USSTRocketry/hardware/README.md

USST Rocketry Avionics hardware

Telemetry board (Infozilla)
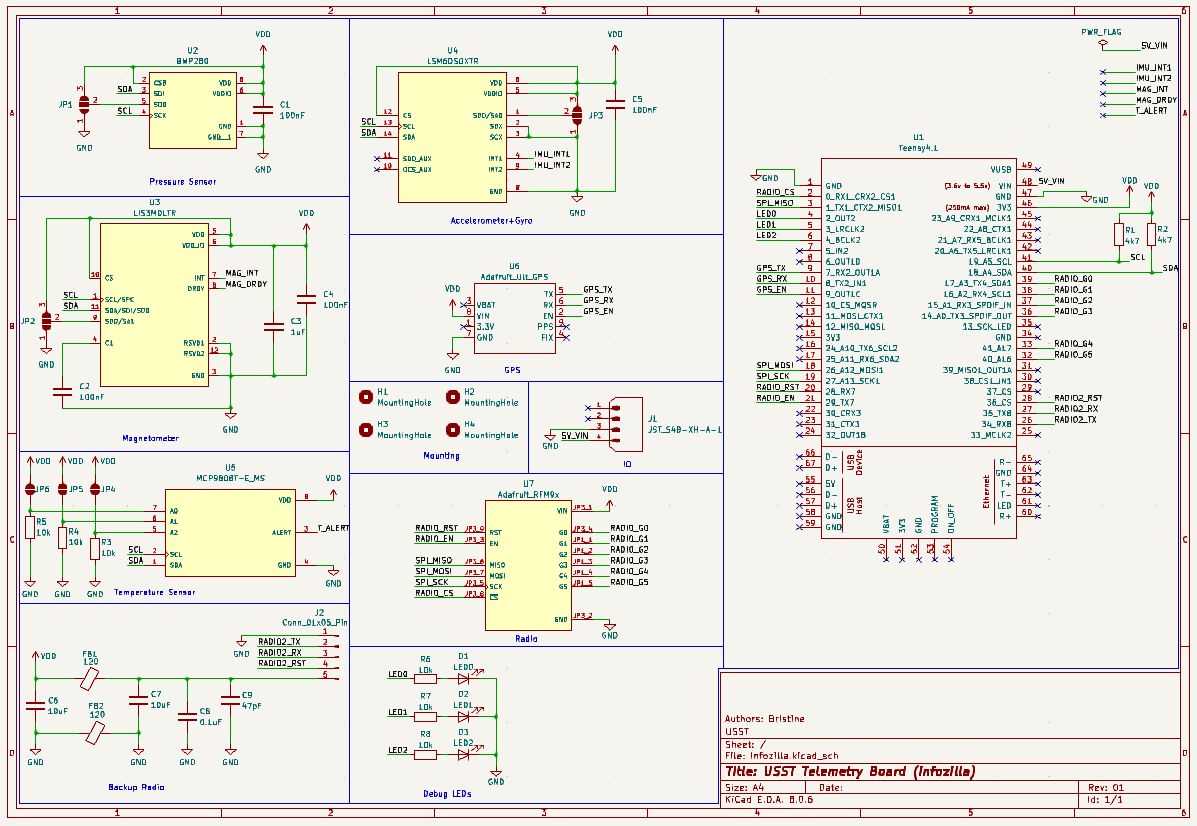
[picture p1: infozilla/schematic.png]

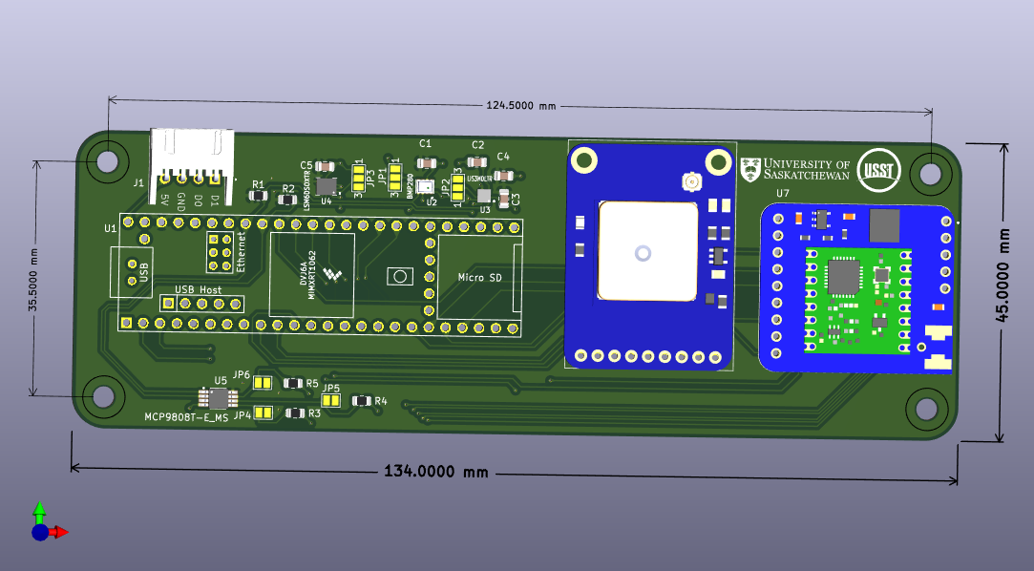
[picture p2: infozilla/3d_view.png]


SRAD flight computer board (Phoenix)
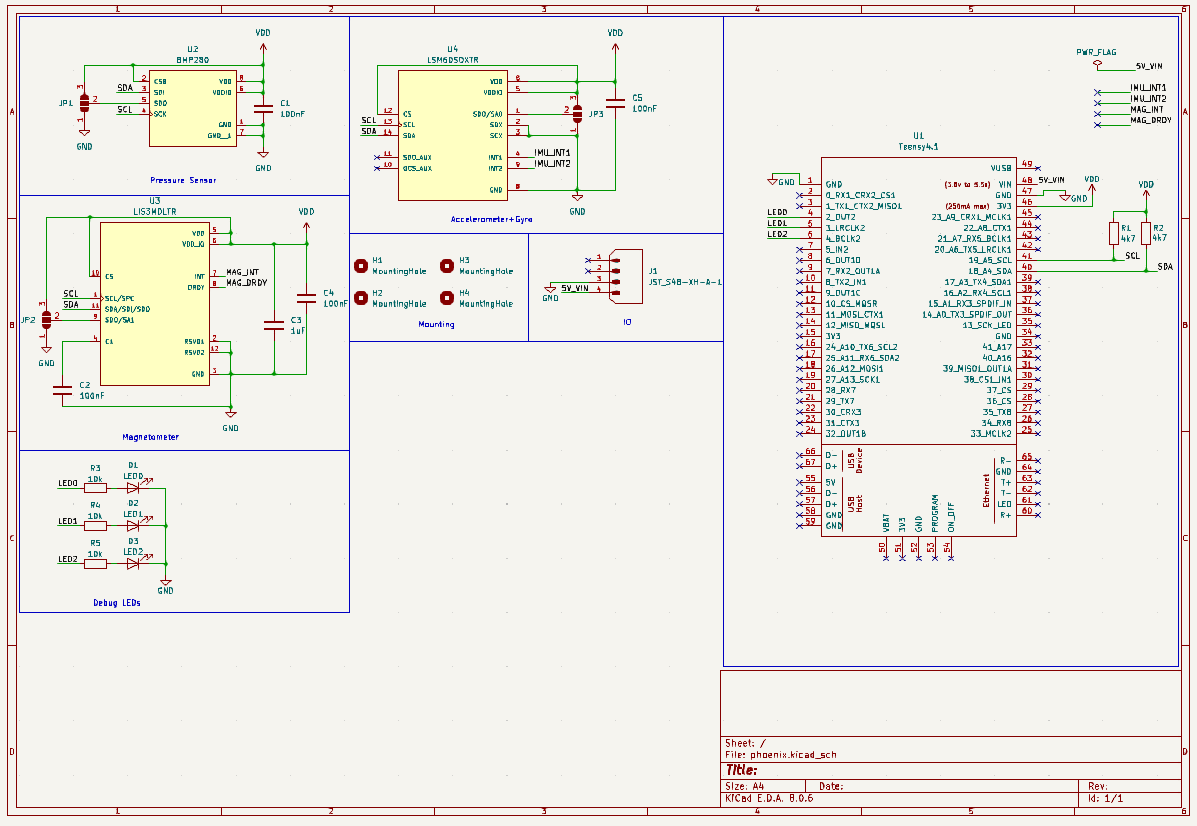
[picture p3: phoenix/schematic.png]

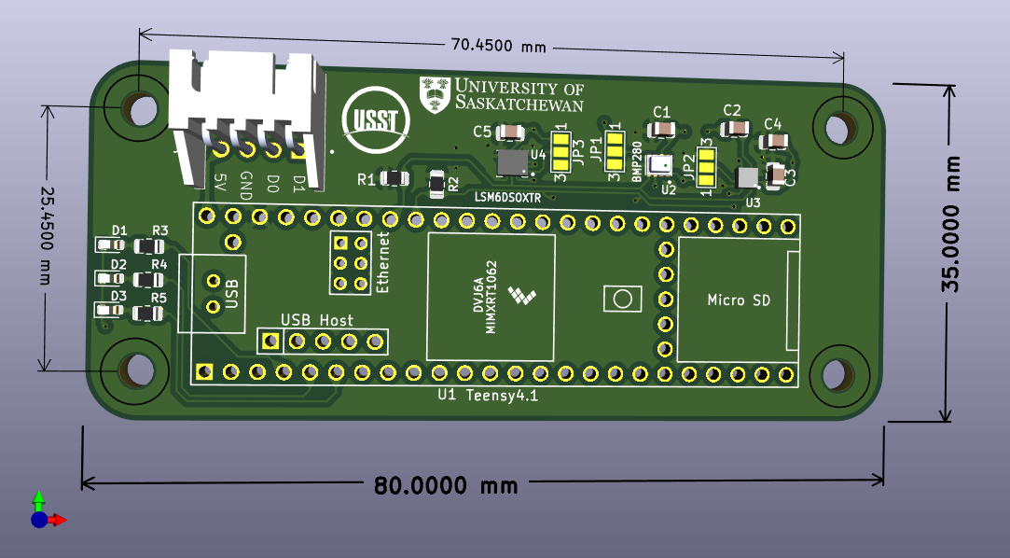
[picture p4: phoenix/3d_view.png]
