USSTRocketry/hardware/docs/adafruit-spi-flash-sd-card.pdf

# Adafruit SPI Flash SD Card

Created by Kattni Rembor

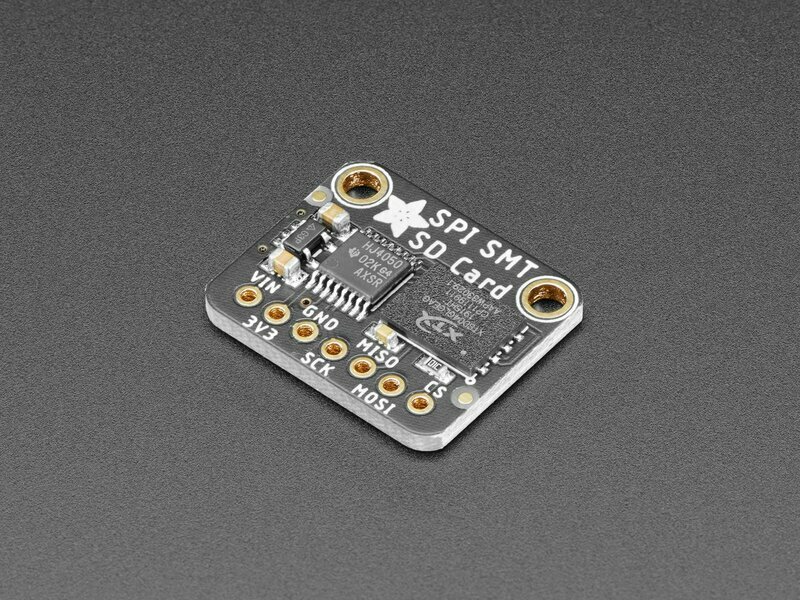
[picture p5: figure]

https://learn.adafruit.com/adafruit-spi-flash-sd-card

Last updated on 2024-06-03 03:19:39 PM EDT

©Adafruit Industries | Page 1 of 9

3
5

6

7

8

## Table of Contents

Overview
Pinouts
- Power Pins
- SPI Logic Pins
Arduino
- Arduino Wiring
- Arduino Usage
CircuitPython
- CircuitPython Wiring
- CircuitPython Usage
Downloads
- Files
- Schematic
- Fab Print

# Overview

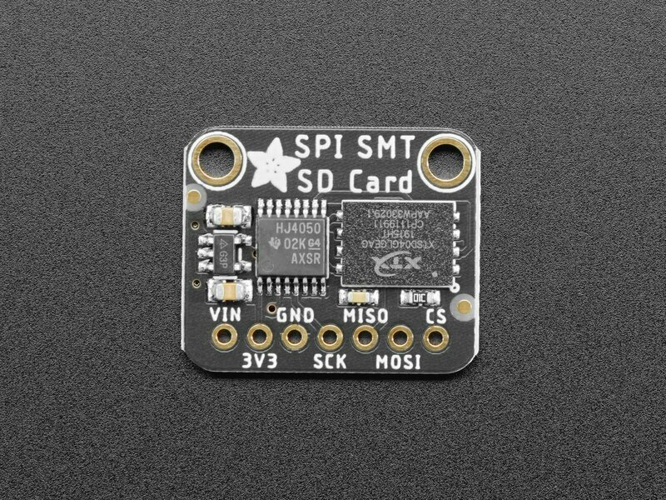
[picture p6: figure]

This breakout is for a fascinating chip - it looks like an SPI Flash storage chip (like the GD25Q16 (https://www.adafruit.com/product/4763) (http://adafru.it/4763)) but its really an SD card, in an SMT chip format. What that means is that you wire up like an SD card breakout, and use the SD card libraries you already have for your microcontroller. For example, you can use the built in SD library in Arduino (https://www.arduino.cc/en/reference/SD) (https://adafru.it/ucu), or for CircuitPython we have an sdcard library (https://learn.adafruit.com/micropython-hardware-sd-cards) (https://adafru.it/Qfr). The breakout will act just like a 512 MB sized card with FAT formatting (it's pre-formatted).

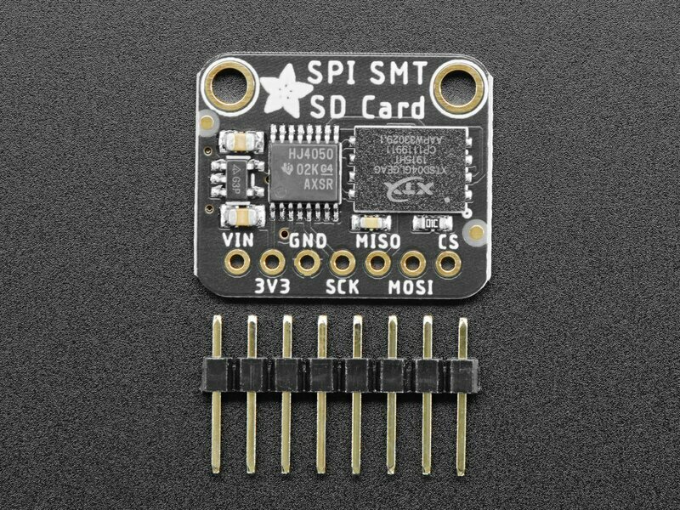
[picture p7: figure]

You might be wondering why you'd want such a thing - after all you can't plug it into a computer to get the files off like MicroSD cards. For some use cases, such as data logging in a high-vibration device where you don't want the SD card to come loose, or for when you need to reduce size, or when the microcontroller provides a USB mass storage interface, this chip could very useful.

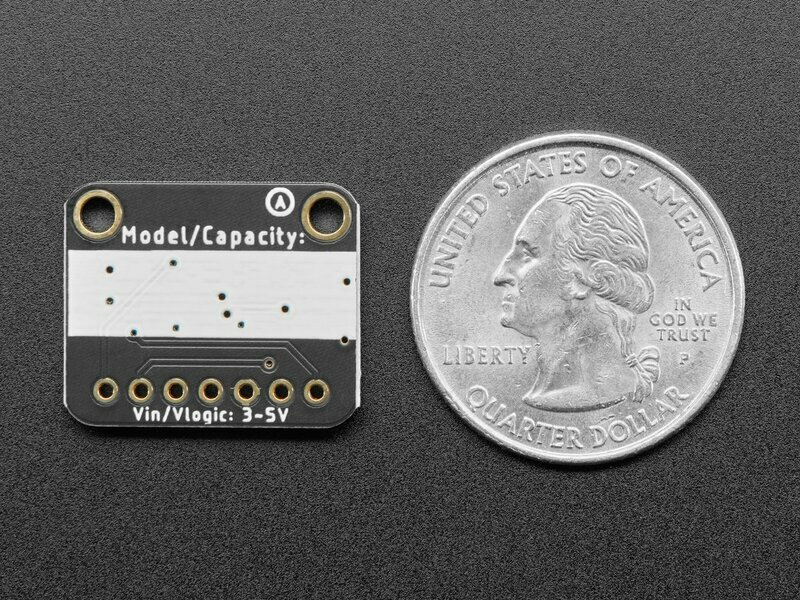
[picture p8: figure]

Compared to plain SPI flash, this NAND memory chip handles all the wear leveling and ECC calculation. You don't have to manually erase blocks, you just write and read them like you would with any SD card. You can clock it up 50 MHz and the 'write speed class' is 8 (although you may not be able to get that fast with plain 1-bit SPI compared to SDIO).

The SPI Flash SD Card cannot simply be plugged into a computer and used as storage space, like you would with a MicroSD card. If you are looking for SD card storage for your PC, consider a regular SD card.

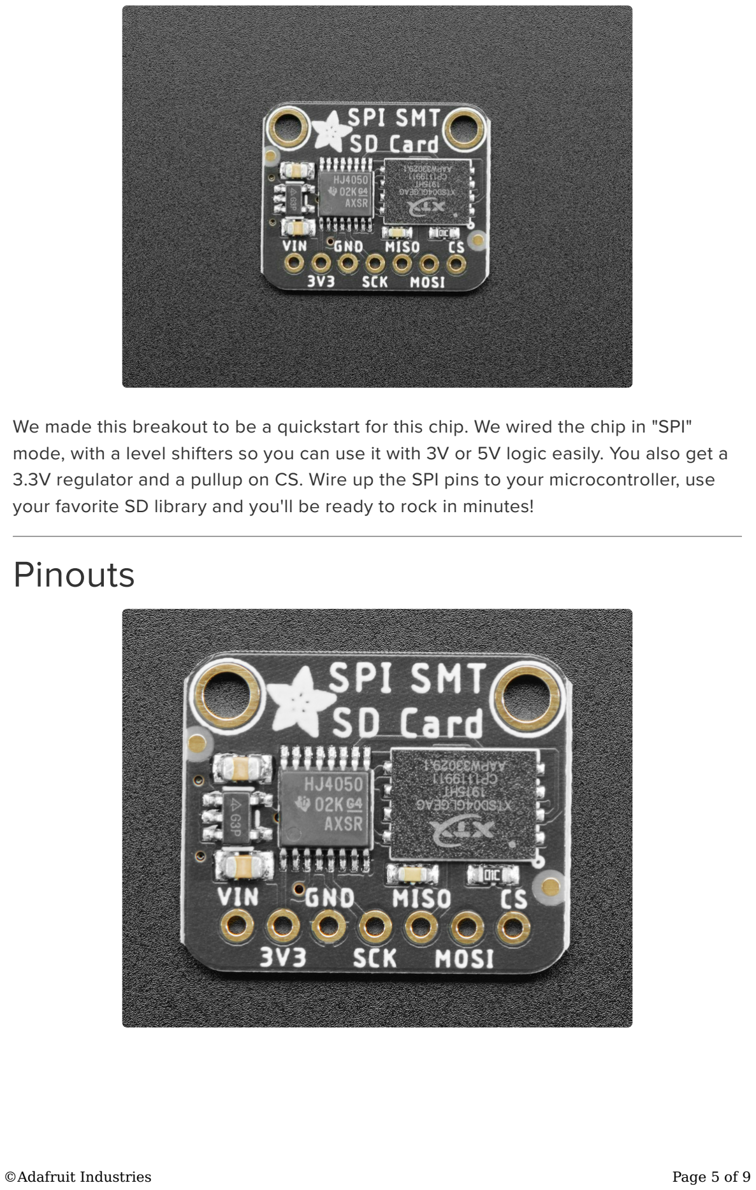
[picture p9: page 5]

We made this breakout to be a quickstart for this chip. We wired the chip in "SPI" mode, with a level shifters so you can use it with 3V or 5V logic easily. You also get a 3.3V regulator and a pullup on CS. Wire up the SPI pins to your microcontroller, use your favorite SD library and you'll be ready to rock in minutes!

# Pinouts

## Power Pins

VIN - this is the power pin. Since the chip uses 3-5VDC you should pick whatever the logic voltage you're using. For most Arduino's that's 5V.
3V3 - this is the 3.3V output from the voltage regulator, you can grab up to 100mA from this if you like
GND - common ground for power and logic

## SPI Logic Pins

All pins are 3-5V compliant and use whatever logic level is on VIN

SCK - This is the SPI clock pin, it's an input to the chip
MISO - this is the Microcontroller In Serial Out pin, for data sent from the SD card to your processor
MOSI - this is the Microcontroller Out Serial In pin, for data sent from your processor to the SD card
CS - this is the chip select pin, drop it low to start an SPI transaction. It's an input to the chip

# Arduino

Using the SPI Flash SD Card breakout with Arduino is as simple as wiring it up to a microcontroller and using the Arduino SD (https://www.arduino.cc/en/reference/SD) (https://adafru.it/ucu) library.

## Arduino Wiring

Wire up your SPI Flash SD Card breakout as shown below. This example shows a Metro wired up using SPI.

•

•

•

•
•

•

•

Arduino 5V to breakout VIN Arduino GND to breakout GND Arduino 11 to breakout MOSI Arduino 12 to breakout MISO Arduino 13 to breakout SCK Arduino 10 to breakout CS

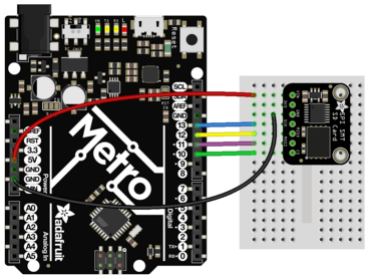
[picture p10: figure]

## Arduino Usage

Check out the Arduino Library page in the Micro SD Card Breakout Board Tutorial guide (https://learn.adafruit.com/adafruit-micro-sd-breakout-board-card-tutorial/arduino-library) (https://adafru.it/Qfs) for everything you need to know about using your SPI Flash SD Card breakout!

# CircuitPython

Using the SPI Flash SD Card breakout with CircuitPython is as simple as wiring it up to a microcontroller and using the Adafruit CircuitPython SD (https://github.com/adafruit/Adafruit_CircuitPython_SD) (https://adafru.it/zwC) library.

It is not recommended to use this with Raspberry Pi and other single-board computers as you already have a full filesystem available to you.

## CircuitPython Wiring

Wire up your SPI Flash SD Card breakout as shown below. This example shows a Feather M4 wired up using SPI.

A user asked about connecting this to a PC. We'd suggest an inexpensive flash drive for such a purpose, this is more for use with microcontrollers.

Board 3V to breakout VIN
Board GND to breakout GND
Board SCK to breakout SCK
Board MI(SO) to breakout MISO Board MO(SI) to breakout MOSI Board D5 to breakout CS

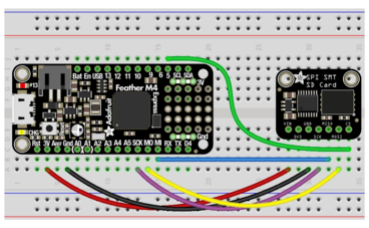
[picture p11: figure]

## CircuitPython Usage

Check out the CircuitPython page in the CircuitPython Hardware: SD Cards guide (https://learn.adafruit.com/micropython-hardware-sd-cards/tdicola-circuitpython) (https://adafru.it/zwE) for everything you need to know about using your SPI Flash SD Card breakout!

# Downloads

## Files

XTSD04GLGEAG Datasheet (https://cdn-learn.adafruit.com/assets/assets/000/098/994/original/2005251034_XTX-XTSD01GLGEAG_C558837.pdf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) (https://adafru.it/Qft)
Fritzing object in Adafruit Fritzing Library (https://github.com/adafruit/Fritzing-Library/blob/master/parts/Adafruit%20SPI%20Flash%20SD%20Card.fzpz) (https://adafru.it/Qfu) EagleCAD PCB files on GitHub (https://github.com/adafruit/Adafruit-SPI-Flash-SD-Card-PCB) (https://adafru.it/Qfv)

•
•
•

# Schematic

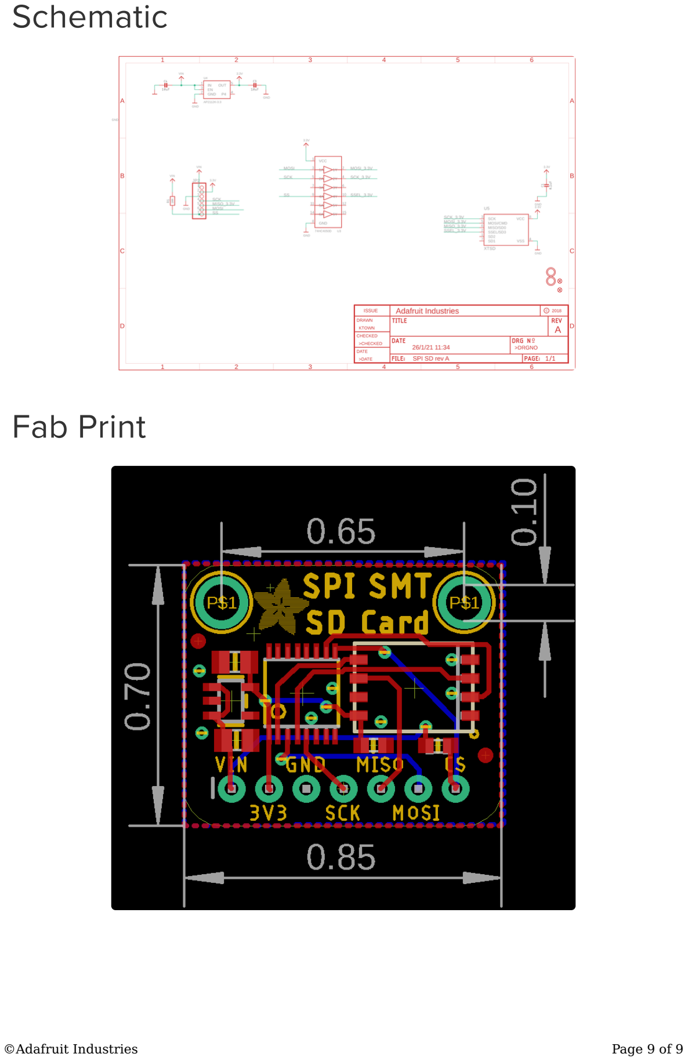
[picture p12: page 9]

# Fab Print
