USSTRocketry/hardware/images/Telemetry_board.png

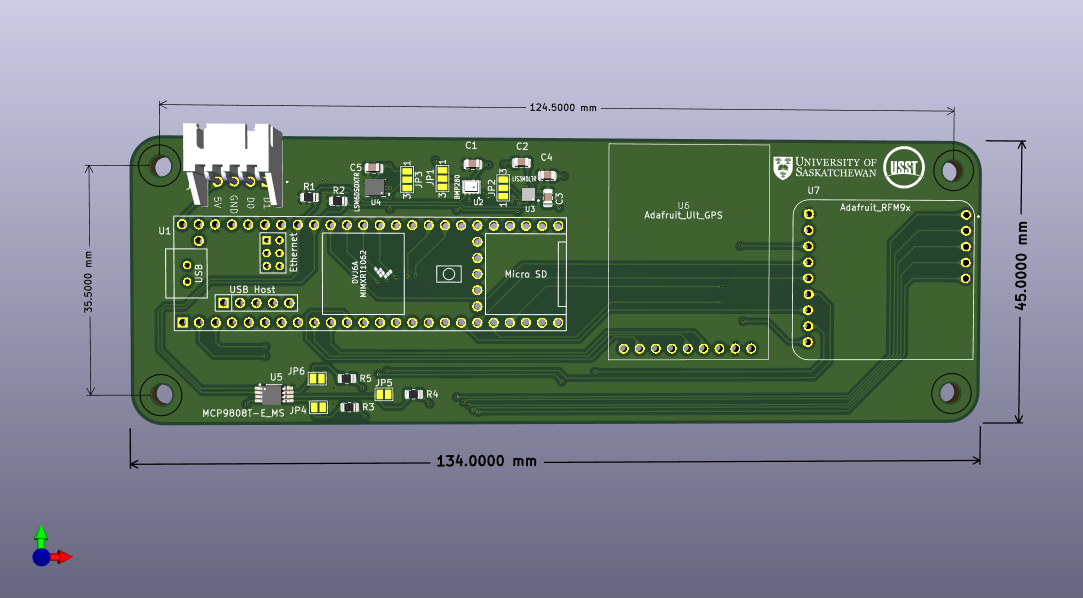
images/Telemetry_board.png
