USSTRocketry/hardware/zappy/zappy_3D.png

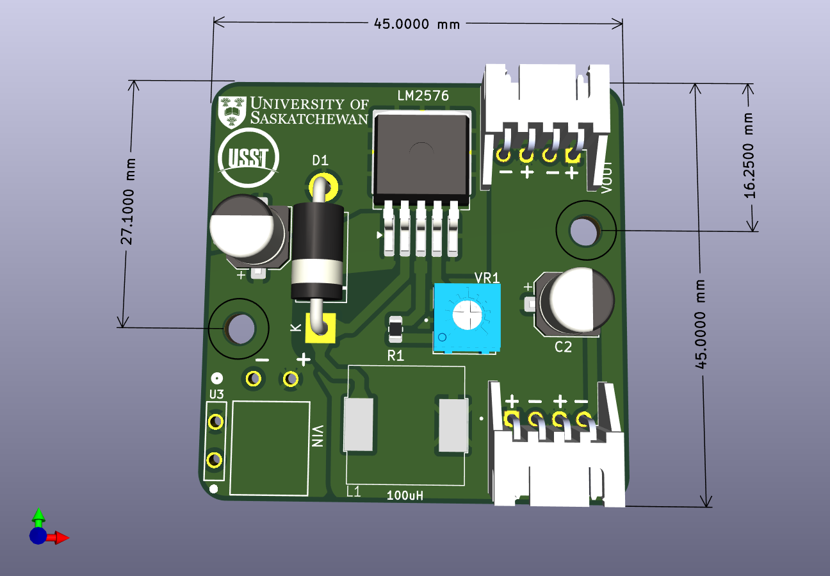
zappy/zappy_3D.png
