USSTRocketry/hardware/custom_library/archieve/3362P_10k_Potentiometer/3362P-1-103LF.step

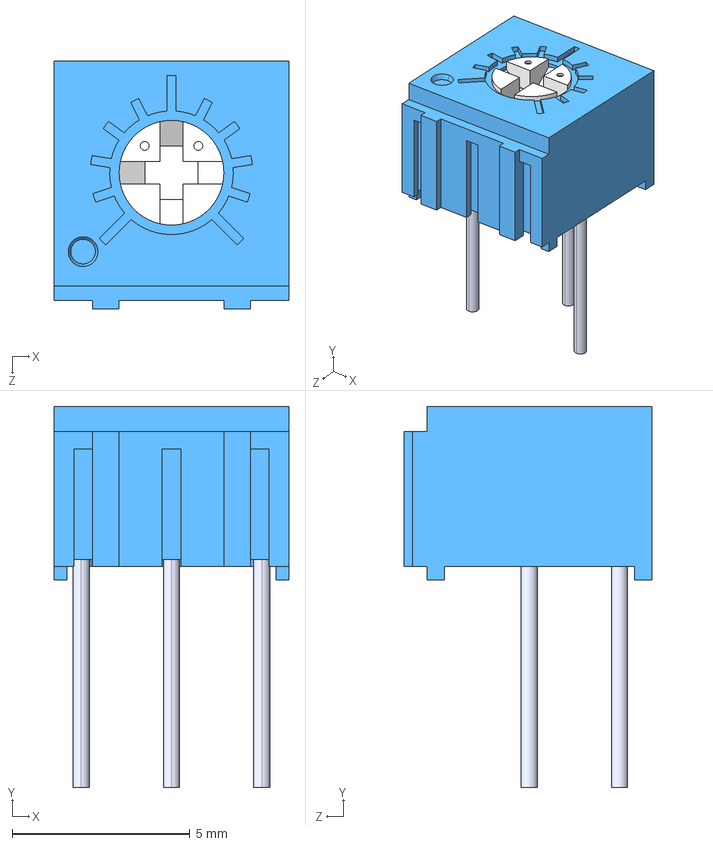
[picture p15: CAD file, 2025-09-03]
custom_library/archieve/3362P_10k_Potentiometer/3362P-1-103LF.step
6.60 x 10.7 x 6.99 mm
