USSTRocketry/hardware/custom_library/archieve/Adafruit_RFM9x/3070.STEP

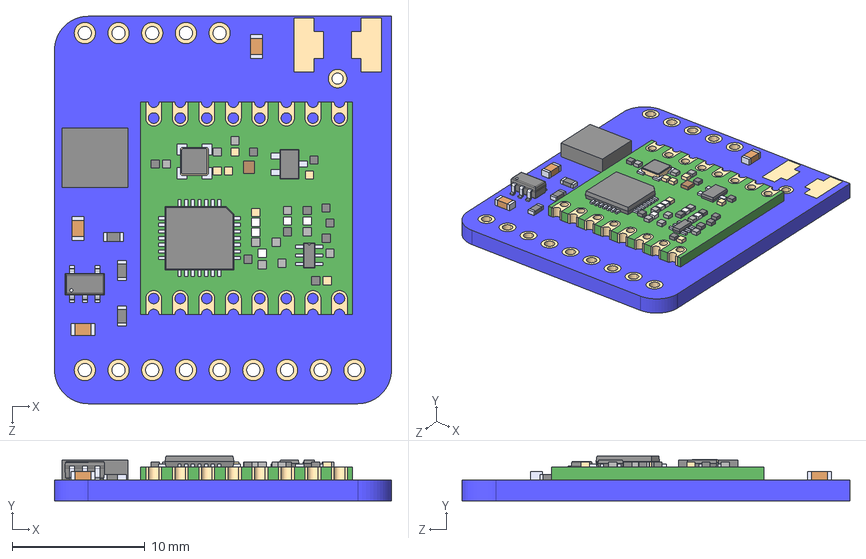
[picture p16: CAD file, 2024-12-05]
custom_library/archieve/Adafruit_RFM9x/3070.STEP
25.4 x 3.37 x 29.2 mm
RFM69HCW_RFM69HCW
AP2112K-3.3_AP2112K-3.3
