USSTRocketry/hardware/custom_library/archieve/Adafuit_Ult_GPS/746.STEP

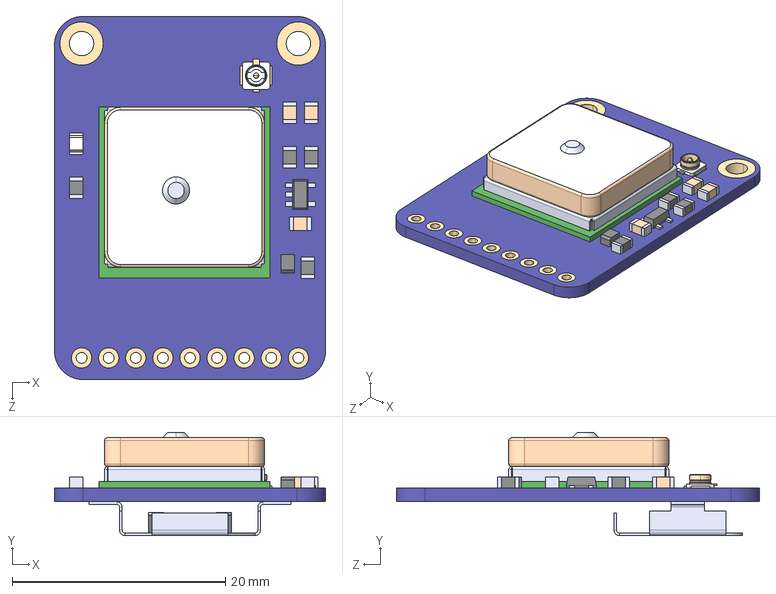
[picture p17: CAD file, 2024-12-05]
custom_library/archieve/Adafuit_Ult_GPS/746.STEP
25.4 x 9.68 x 34.0 mm
