USSTRocketry/hardware/custom_library/archieve/BMP280/BMP280.step

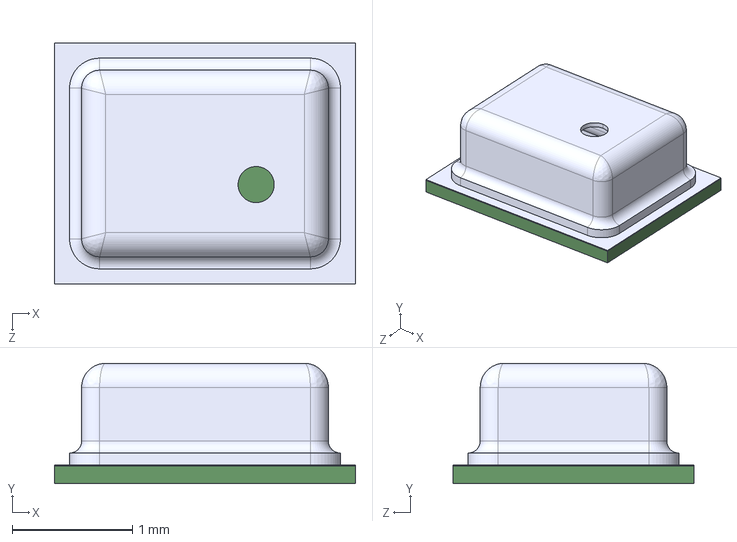
[picture p18: CAD file, 2024-11-25]
custom_library/archieve/BMP280/BMP280.step
2.50 x 1.00 x 2.00 mm
