USSTRocketry/hardware/custom_library/archieve/JST_B4B_XH_A/B4B-XH-A.step

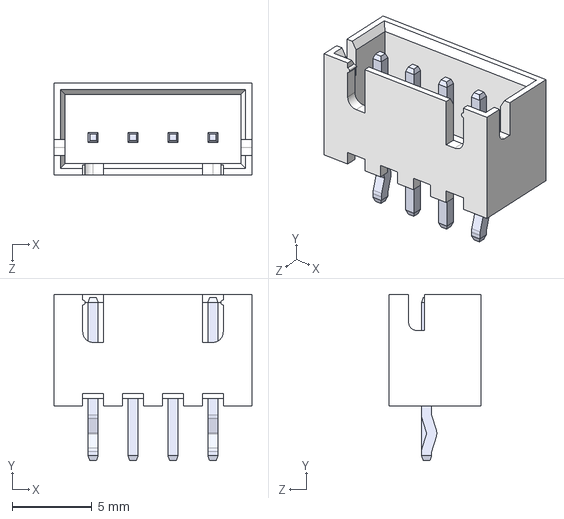
[picture p19: CAD file, 2024-12-05]
custom_library/archieve/JST_B4B_XH_A/B4B-XH-A.step
12.4 x 10.4 x 5.75 mm
