USSTRocketry/hardware/custom_library/archieve/LIS3MDLTR/LIS3MDLTR.step

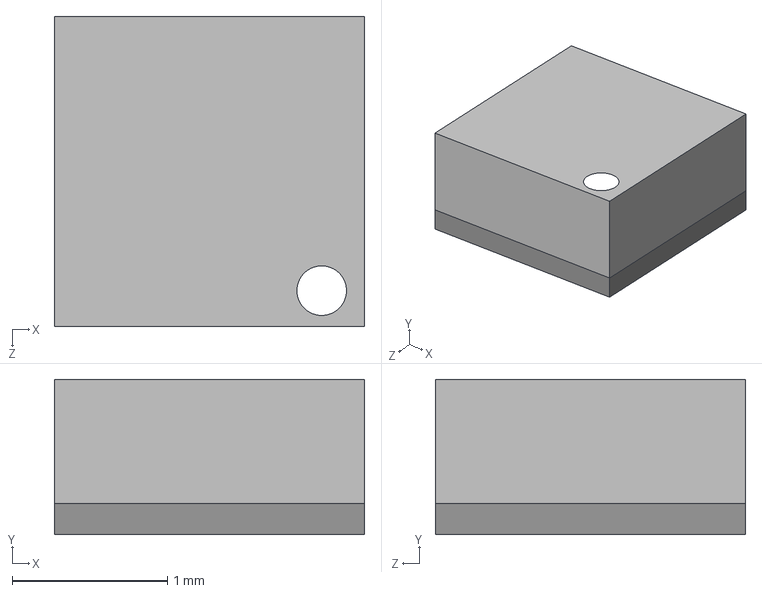
[picture p20: CAD file, 2024-11-25]
custom_library/archieve/LIS3MDLTR/LIS3MDLTR.step
2.00 x 1.00 x 2.00 mm
