USSTRocketry/hardware/custom_library/archieve/LM2576S_ADJ_SMD/LM2576S-ADJ_NOPB.step

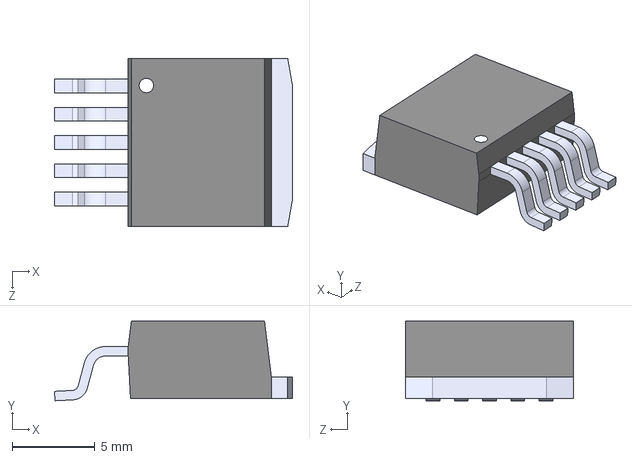
[picture p21: CAD file, 2025-09-03]
custom_library/archieve/LM2576S_ADJ_SMD/LM2576S-ADJ_NOPB.step
14.4 x 4.80 x 10.2 mm
