USSTRocketry/hardware/custom_library/archieve/LM2576T-ADJ_LF03/LM2576T-ADJ_LF03.step

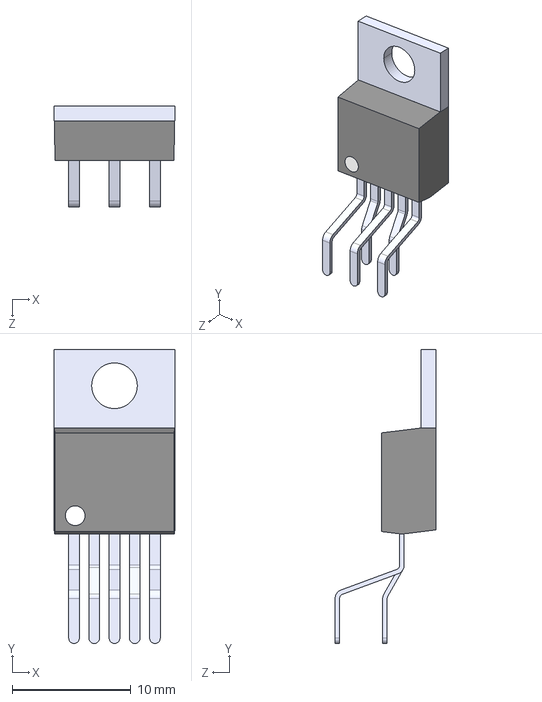
[picture p22: CAD file, 2025-09-03]
custom_library/archieve/LM2576T-ADJ_LF03/LM2576T-ADJ_LF03.step
10.2 x 24.7 x 8.47 mm
