USSTRocketry/hardware/custom_library/archieve/LSM6DSOXTR/LSM6DSOXTR.step

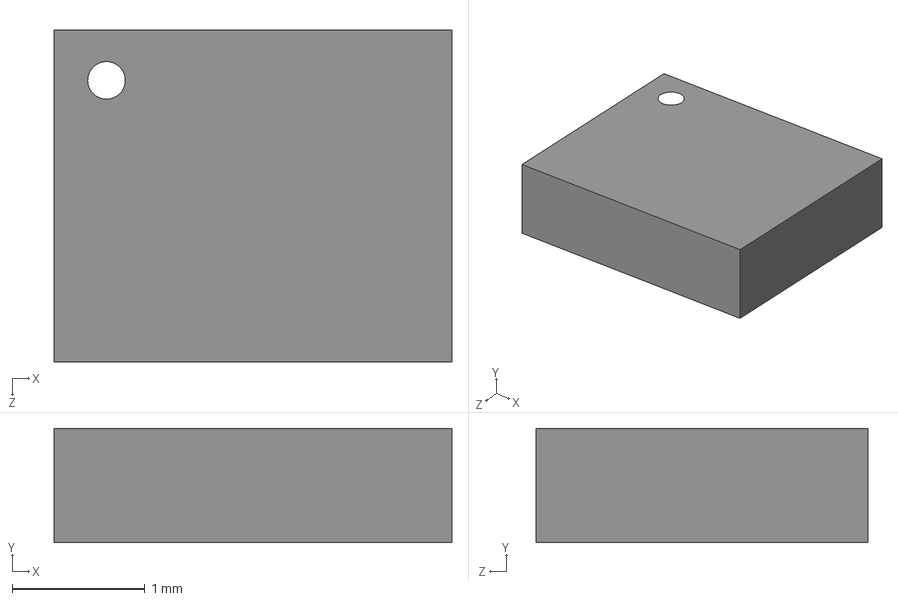
[picture p23: CAD file, 2024-11-25]
custom_library/archieve/LSM6DSOXTR/LSM6DSOXTR.step
3.00 x 0.86 x 2.50 mm
