USSTRocketry/hardware/custom_library/archieve/MCP9808T-E_MS/MCP9808T-E_MS.step

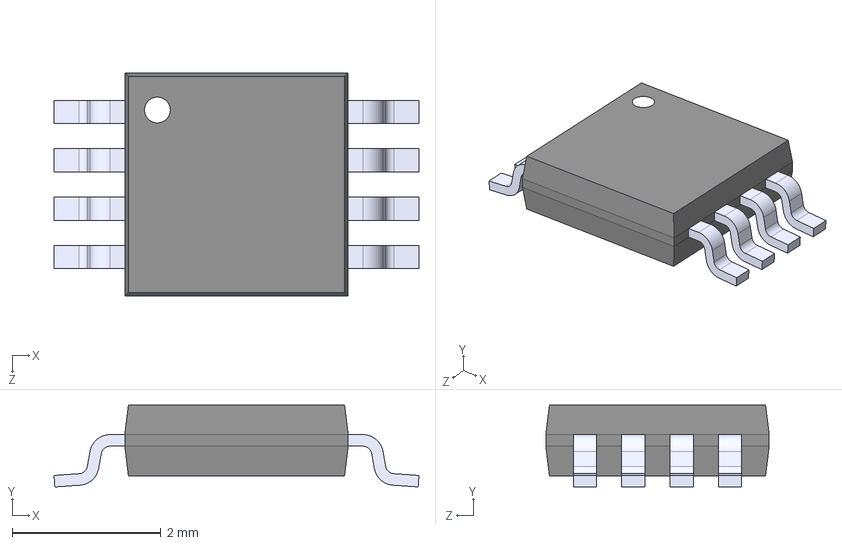
[picture p24: CAD file, 2024-12-05]
custom_library/archieve/MCP9808T-E_MS/MCP9808T-E_MS.step
4.90 x 1.10 x 3.00 mm
