USSTRocketry/hardware/custom_library/archieve/RFM95W_915S2/RFM95W-915S2.step

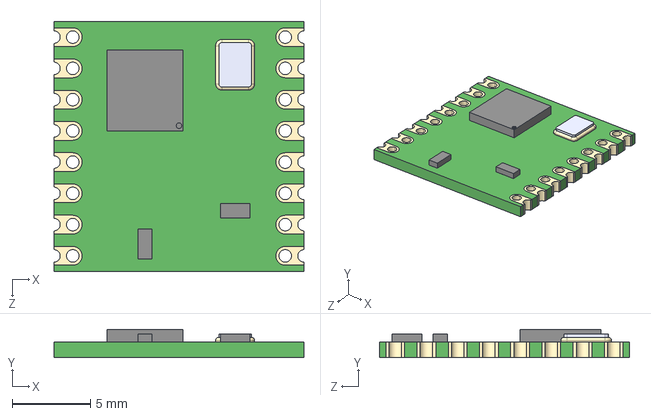
[picture p25: CAD file, 2024-12-05]
custom_library/archieve/RFM95W_915S2/RFM95W-915S2.step
16.0 x 1.80 x 16.0 mm
