USSTRocketry/hardware/custom_library/archieve/S4B_XH_A_1_Right_angle_JST/S4B-XH-A-1.step

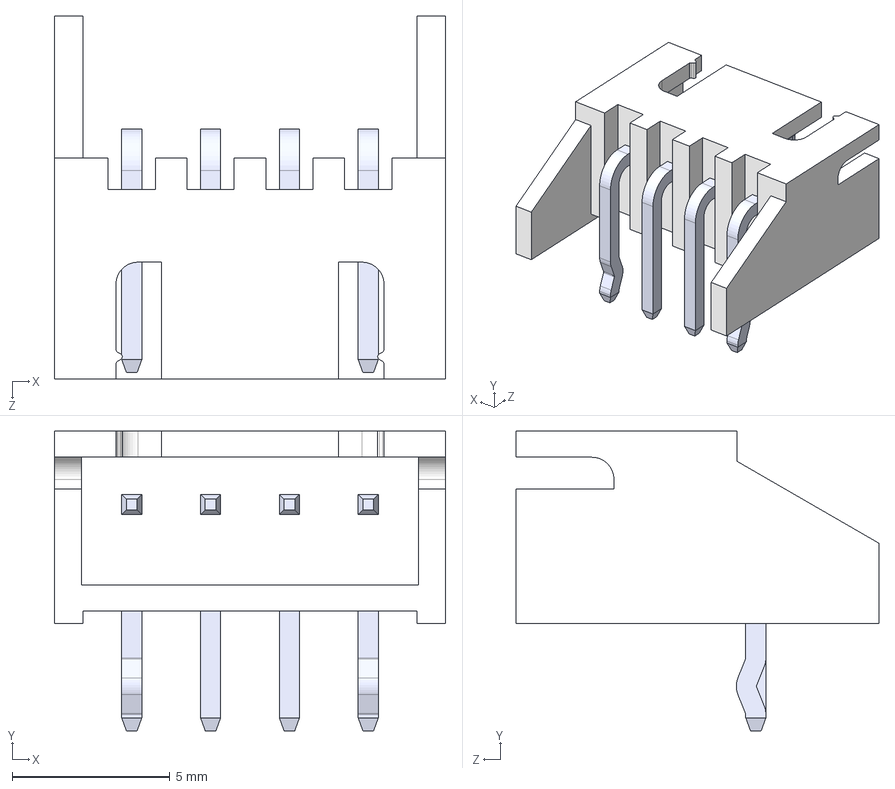
[picture p26: CAD file, 2024-12-05]
custom_library/archieve/S4B_XH_A_1_Right_angle_JST/S4B-XH-A-1.step
12.4 x 9.50 x 11.5 mm
SxB-XH-Axxxxx_4
pin^SxB-XH-A-1(LF)(SN)_bent x 2
pin^SxB-XH-A-1(LF)(SN) x 2
