USSTRocketry/hardware/custom_library/archieve/W25Q128JVSSIQ/W25Q128JVSSIQ.step

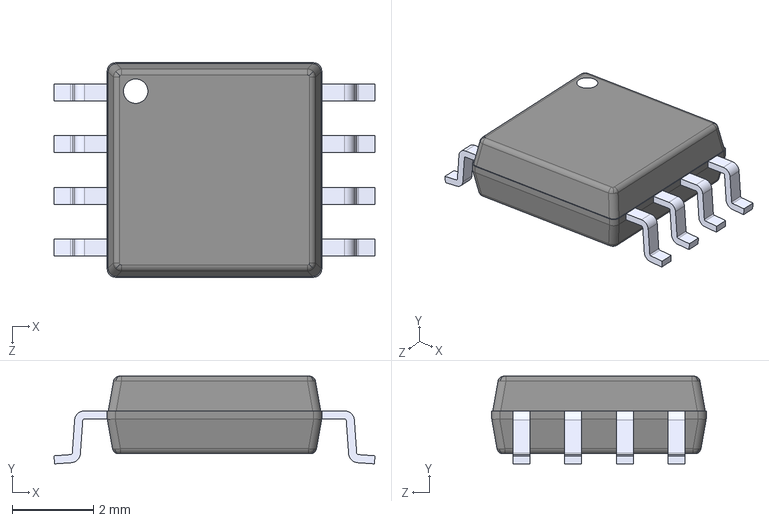
[picture p27: CAD file, 2024-12-05]
custom_library/archieve/W25Q128JVSSIQ/W25Q128JVSSIQ.step
7.90 x 2.16 x 5.28 mm
