USSTRocketry/hardware/infozilla/infozilla.step

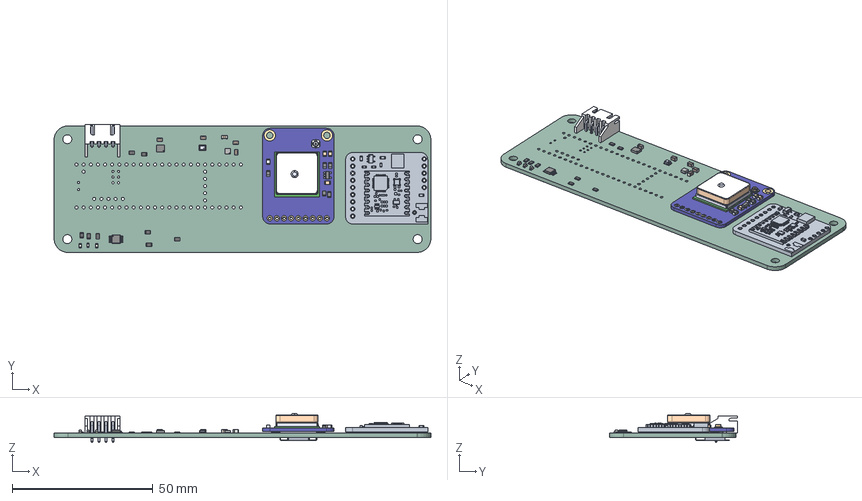
[picture p28: CAD file, 2025-09-03]
infozilla/infozilla.step
134.0 x 45.5 x 10.4 mm
R_0805_2012Metric x 8
LED_0603_1608Metric x 3
C_0805_2012Metric x 9
ASM330LHHXTR
ADA746
L_0402_1005Metric x 2
LIS3MDLTR
BMP280
24LC256T-I_MS
S4B-XH-A-1
infozilla_PCB
