USSTRocketry/hardware/phoenix/phoenix.step

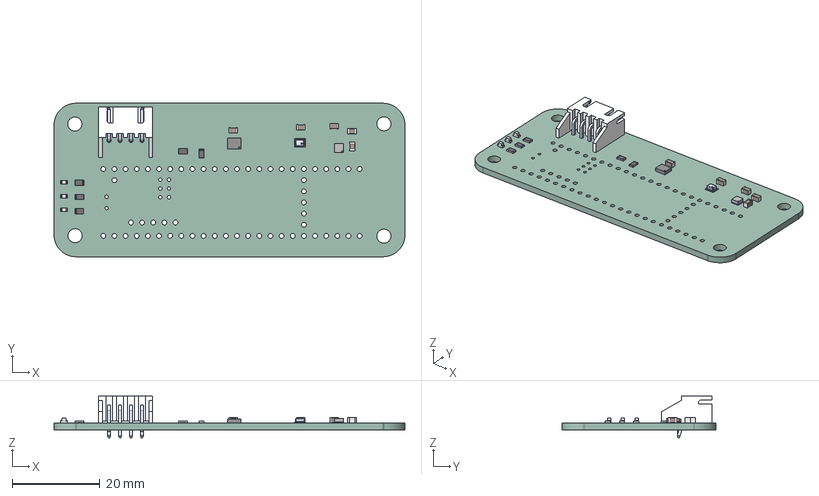
[picture p29: CAD file, 2025-09-03]
phoenix/phoenix.step
80.0 x 35.0 x 9.50 mm
R_0805_2012Metric x 5
C_0805_2012Metric x 5
LIS3MDLTR
ASM330LHHXTR
LED_0603_1608Metric x 3
S4B-XH-A-1
BMP280
phoenix_PCB
