USSTRocketry/hardware/zappy/zappy.step

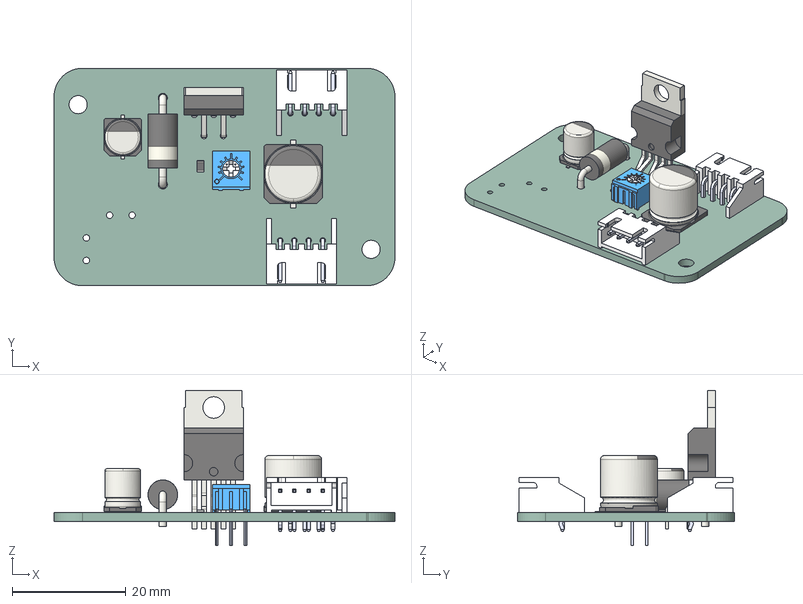
[picture p30: CAD file, 2025-09-03]
zappy/zappy.step
60.0 x 38.2 x 27.3 mm
CP_Elec_63x77
R_0805_2012Metric
S4B-XH-A-1 x 2
TO_220_5_Pentawatt_Multiwatt_5_Vertical_StaggeredType2
D_DO-201AD_P15.24mm_Horizontal
CP_Elec_10x10
3362P-1-103
zappy_PCB
