USSTRocketry/hardware/infozilla/schematic.pdf

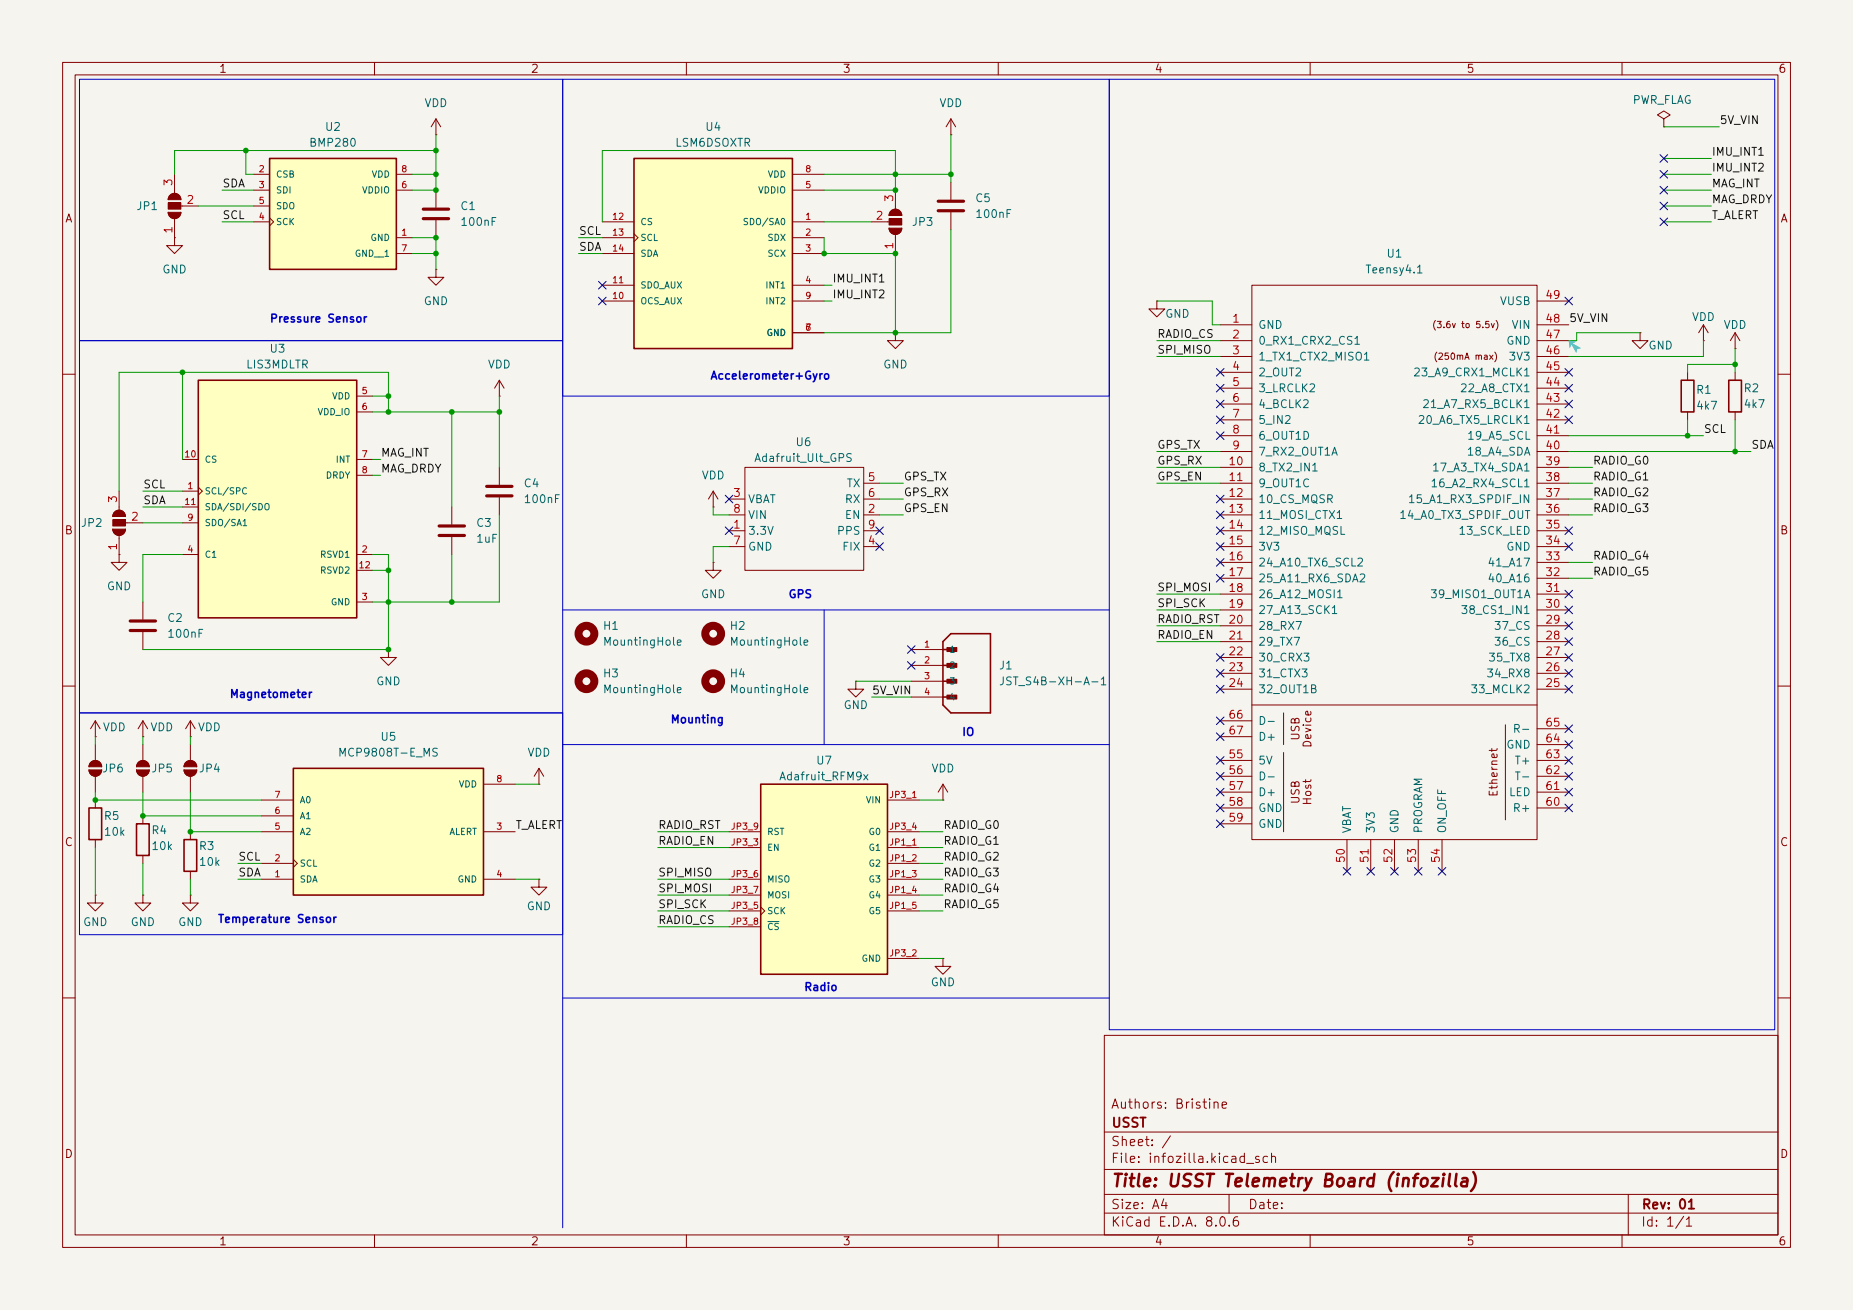
[picture p31: page 1]
