USSTRocketry/hardware/zappy/zappy.kicad_pcb

## KiCad design zappy/zappy.kicad_pcb (2025-09-03)

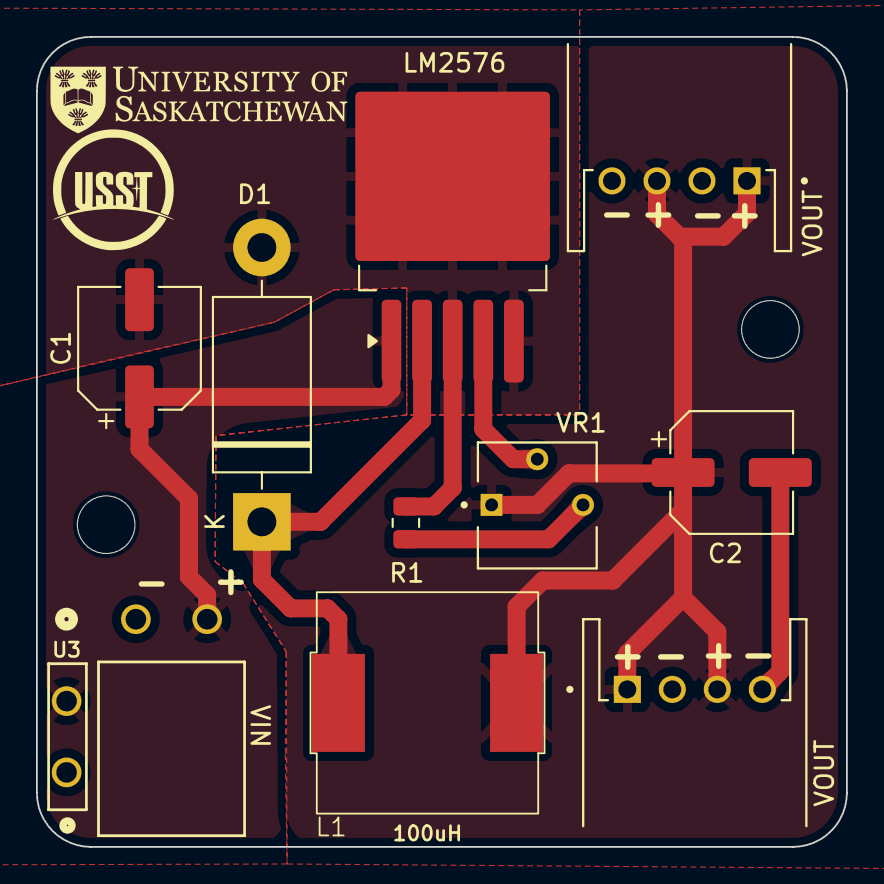
[picture p32: board zappy.kicad_pcb from above]

Board: 2 copper layers, 45.0 x 45.0 mm, 13 parts (0 on the bottom side), 6 nets.

Parts:
C1: 100uF; CP_Elec_6.3x7.7
C2: 330uF; CP_Elec_6.3x7.7
D1: 1N5822; D_DO-201AD_P15.24mm_Horizontal
H1, H2: MountingHole; MountingHole_3.2mm_M3
L1: 100uH; SMDRI127-101MT
LM2576: LM2576T-ADJ; TO-263-5_TabPin3
R1: 3k8; R_0805_2012Metric
U3: S2P-VH; S2P-VH_JST_Only_holes
VIN: S2P-VH; S2P-VH_JST
VOUT: JST_S4B-XH-A-1
VOUT#2: JST_S4B-XH-A-1
VR1: TRIM_3362P_10k_VR; TRIM_3362P-1-103LF

Connections:
/Vin: C1.1, LM2576.1 (VIN), U3.2, VIN.2
/Vout: C2.1, L1.2, VOUT.1, VOUT.3, VOUT#2.1, VOUT#2.3, VR1.1
GND: C1.2, C2.2, D1.2 (A), LM2576.3 (GND), LM2576.5 (~ON/OFF), R1.2, U3.1, VIN.1, VOUT.2, VOUT.4, VOUT#2.2, VOUT#2.4
unnamed: D1.1 (K), L1.1, LM2576.2 (OUT)
unnamed: R1.1, VR1.3
unnamed: LM2576.4 (FB), VR1.2
