USSTRocketry/hardware/infozilla/infozilla.kicad_pcb

## KiCad design infozilla/infozilla.kicad_pcb (2025-09-03)

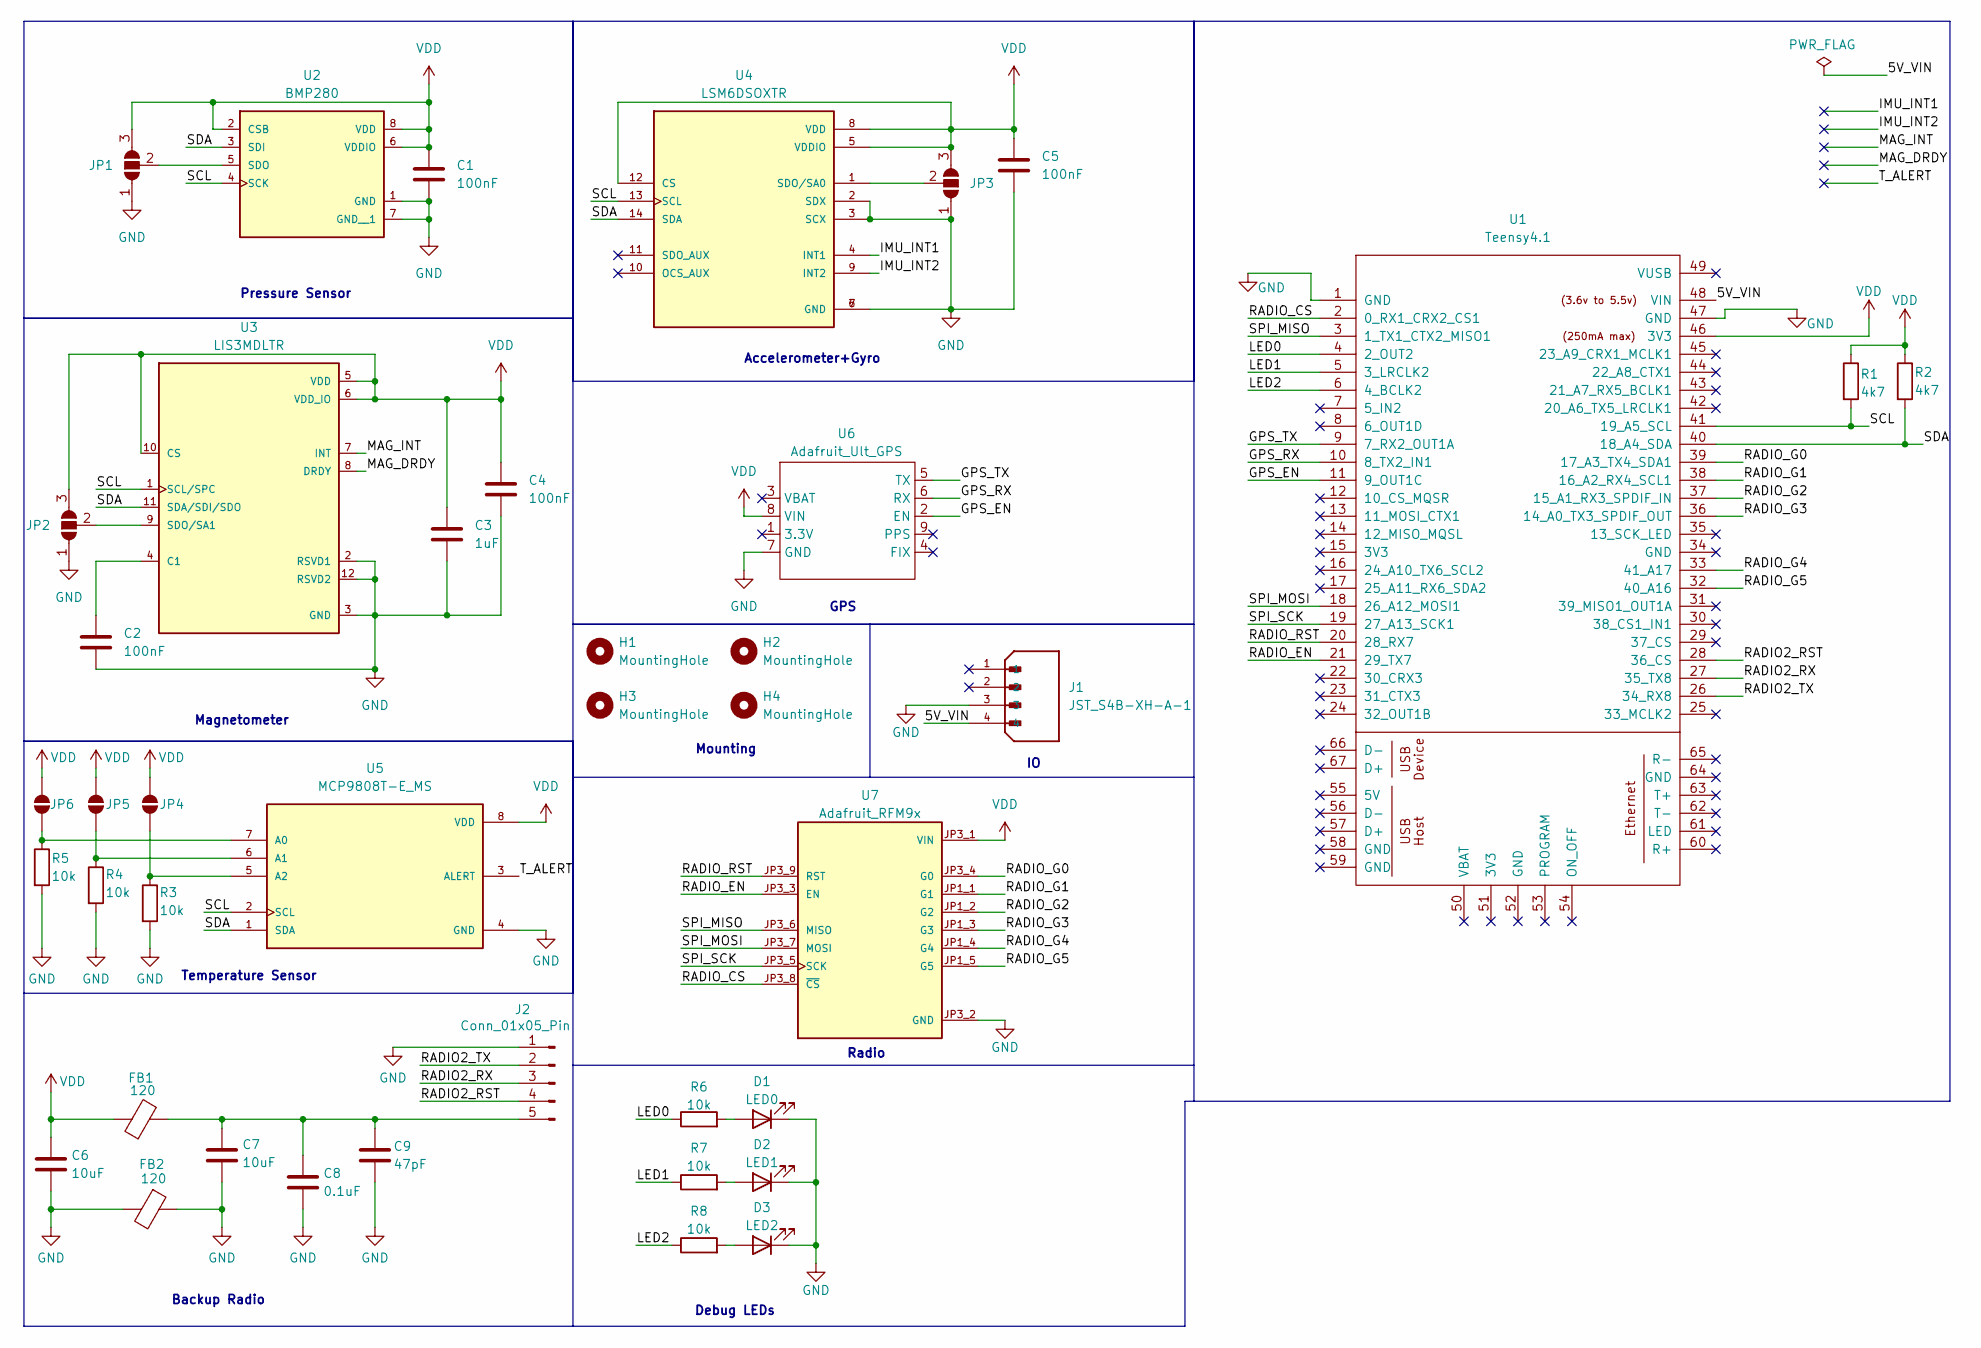
[picture p33: schematic infozilla.kicad_sch, USST Telemetry Board (infozilla)]

Parts:
C1, C2, C4, C5: 100nF; C_0805_2012Metric
C3: 1uF; C_0805_2012Metric
C6, C7: 10uF; C_0805_2012Metric
C8: 0.1uF; C_0805_2012Metric
C9: 47pF; C_0805_2012Metric
D1: LED0; LED_0603_1608Metric
D2: LED1; LED_0603_1608Metric
D3: LED2; LED_0603_1608Metric
FB1, FB2: 120; L_0402_1005Metric
H1, H2, H3, H4: MountingHole; MountingHole_3.2mm_M3
J1: JST_S4B-XH-A-1; PARTREV 27-1-20
J2: Conn_01x05_Pin; PinHeader_1x05_P2.54mm_Vertical
JP1, JP2, JP3: SolderJumper_3_Open; SolderJumper-3_P1.3mm_Open_Pad1.0x1.5mm_NumberLabels
JP4, JP5, JP6: SolderJumper_2_Open; SolderJumper-2_P1.3mm_Open_Pad1.0x1.5mm
R1, R2: 4k7; R_0805_2012Metric
R3, R4, R5, R6, R7, R8: 10k; R_0805_2012Metric
U1: Teensy4.1; Teensy41
U2: BMP280; PART_REV 1.19
U3: LIS3MDLTR; PARTREV 6
U4: LSM6DSOXTR; PARTREV 3.0
U5: MCP9808T-E_MS
U6: Adafruit_Ult_GPS
U7: Adafruit_RFM9x; Adafuit_RFM9x; PARTREV 2023-10-24

Connections:
/5V_VIN: J1.4, U1.48 (VIN)
/GPS_EN: U1.11 (9_OUT1C), U6.2 (EN)
/GPS_RX: U1.10 (8_TX2_IN1), U6.6 (RX)
/GPS_TX: U1.9 (7_RX2_OUT1A), U6.5 (TX)
/IMU_INT1: U4.4 (INT1)
/IMU_INT2: U4.9 (INT2)
/LED0: R6.1, U1.4 (2_OUT2)
/LED1: R7.1, U1.5 (3_LRCLK2)
/LED2: R8.1, U1.6 (4_BCLK2)
/MAG_DRDY: U3.8 (DRDY)
/MAG_INT: U3.7 (INT)
/RADIO2_RST: J2.4, U1.28 (36_CS)
/RADIO2_RX: J2.3, U1.27 (35_TX8)
/RADIO2_TX: J2.2, U1.26 (34_RX8)
/RADIO_CS: U1.2 (0_RX1_CRX2_CS1), U7.JP3_8 (~CS)
/RADIO_EN: U1.21 (29_TX7), U7.JP3_3 (EN)
/RADIO_G0: U1.39 (17_A3_TX4_SDA1), U7.JP3_4 (G0)
/RADIO_G1: U1.38 (16_A2_RX4_SCL1), U7.JP1_1 (G1)
/RADIO_G2: U1.37 (15_A1_RX3_SPDIF_IN), U7.JP1_2 (G2)
/RADIO_G3: U1.36 (14_A0_TX3_SPDIF_OUT), U7.JP1_3 (G3)
/RADIO_G4: U1.33 (41_A17), U7.JP1_4 (G4)
/RADIO_G5: U1.32 (40_A16), U7.JP1_5 (G5)
/RADIO_RST: U1.20 (28_RX7), U7.JP3_9 (RST)
/SCL: R1.2, U1.41 (19_A5_SCL), U2.4 (SCK), U3.1 (SCL/SPC), U4.13 (SCL), U5.2 (SCL)
/SDA: R2.2, U1.40 (18_A4_SDA), U2.3 (SDI), U3.11 (SDA/SDI/SDO), U4.14 (SDA), U5.1 (SDA)
/SPI_MISO: U1.3 (1_TX1_CTX2_MISO1), U7.JP3_6 (MISO)
/SPI_MOSI: U1.18 (26_A12_MOSI1), U7.JP3_7 (MOSI)
/SPI_SCK: U1.19 (27_A13_SCK1), U7.JP3_5 (SCK)
/T_ALERT: U5.3 (ALERT)
GND: C1.2, C2.2, C3.2, C4.2, C5.1, C6.2, C7.2, C8.2, C9.2, D1.1 (K), D2.1 (K), D3.1 (K), FB2.1, FB2.2, J1.3, J2.1, JP1.1 (A), JP2.1 (A), JP3.1 (A), R3.2, R4.2, R5.2, U1.1 (GND), U1.47 (GND), U2.1 (GND), U2.7 (GND__1), U3.2 (RSVD1), U3.3 (GND), U3.12 (RSVD2), U4.2 (SDX), U4.3 (SCX), U4.6 (GND), U4.7 (GND), U5.4 (GND), U6.7 (GND), U7.JP3_2 (GND)
unnamed: D1.2 (A), R6.2
unnamed: D2.2 (A), R7.2
unnamed: D3.2 (A), R8.2
unnamed: C7.1, C8.1, C9.1, FB1.2, J2.5
unnamed: JP1.2 (C), U2.5 (SDO)
unnamed: JP2.2 (C), U3.9 (SDO/SA1)
unnamed: JP3.2 (C), U4.1 (SDO/SA0)
unnamed: JP4.1 (A), R3.1, U5.5 (A2)
unnamed: JP5.1 (A), R4.1, U5.6 (A1)
unnamed: JP6.1 (A), R5.1, U5.7 (A0)
unnamed: C2.1, U3.4 (C1)
VDD: C1.1, C3.1, C4.1, C5.2, C6.1, FB1.1, JP1.3 (B), JP2.3 (B), JP3.3 (B), JP4.2 (B), JP5.2 (B), JP6.2 (B), R1.1, R2.1, U1.46 (3V3), U2.2 (CSB), U2.6 (VDDIO), U2.8 (VDD), U3.5 (VDD), U3.6 (VDD_IO), U3.10 (CS), U4.5 (VDDIO), U4.8 (VDD), U4.12 (CS), U5.8 (VDD), U6.8 (VIN), U7.JP3_1 (VIN)

Notes on the sheet:
Radio
Mounting
Magnetometer
Debug LEDs
Backup Radio
Pressure Sensor
Temperature Sensor
GPS
Accelerometer+Gyro

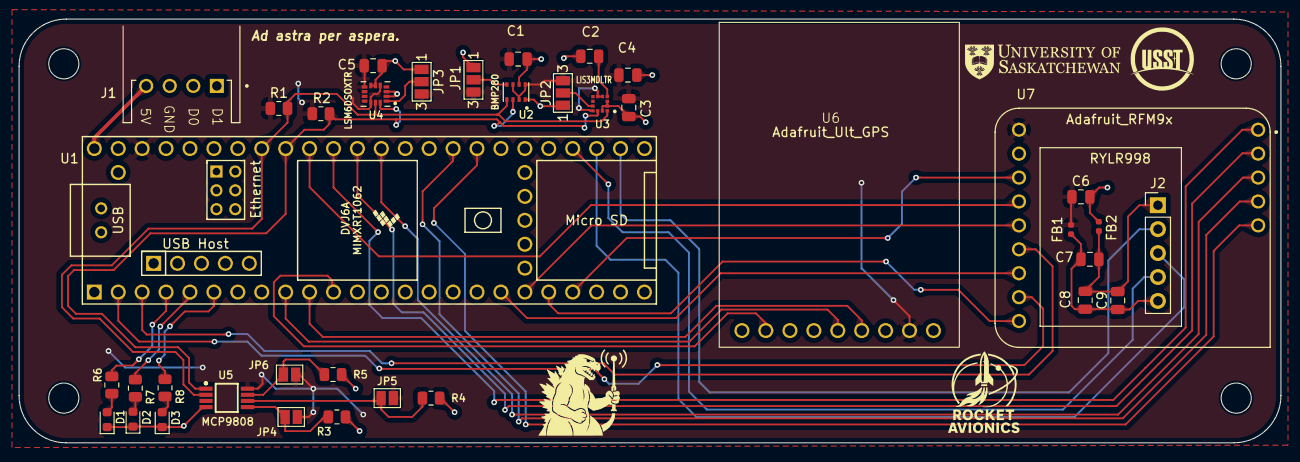
[picture p34: board infozilla.kicad_pcb from above]

Board: 2 copper layers, 134.0 x 45.0 mm, 41 parts (0 on the bottom side), 37 nets.
