USSTRocketry/hardware/phoenix/phoenix.kicad_pcb

## KiCad design phoenix/phoenix.kicad_pcb (2025-09-03)

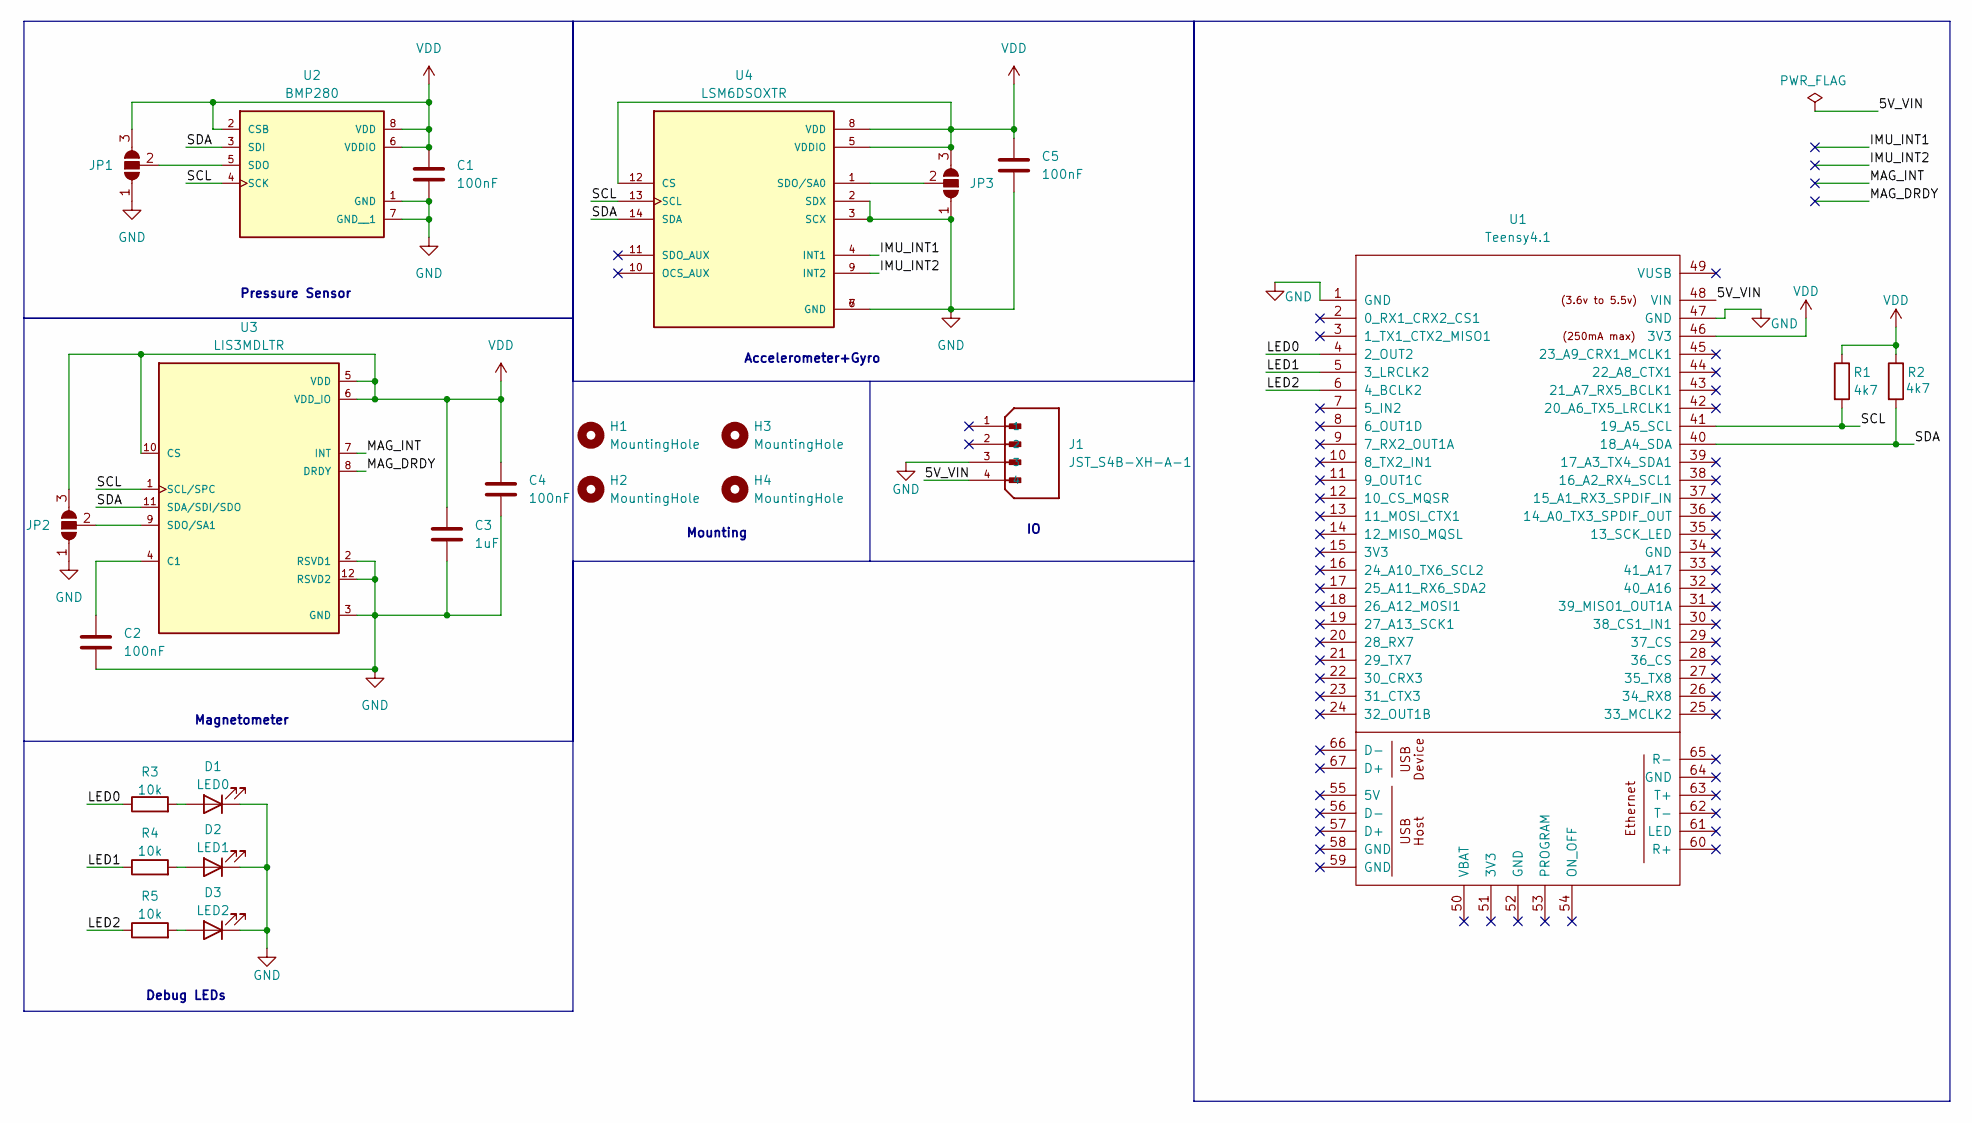
[picture p35: schematic phoenix.kicad_sch]

Parts:
C1, C2, C4, C5: 100nF; C_0805_2012Metric
C3: 1uF; C_0805_2012Metric
D1: LED0; LED_0603_1608Metric
D2: LED1; LED_0603_1608Metric
D3: LED2; LED_0603_1608Metric
H1, H2, H3, H4: MountingHole; MountingHole_3.2mm_M3
J1: JST_S4B-XH-A-1; PARTREV 27-1-20
JP1, JP2, JP3: SolderJumper_3_Open; SolderJumper-3_P1.3mm_Open_Pad1.0x1.5mm_NumberLabels
R1, R2: 4k7; R_0805_2012Metric
R3, R4, R5: 10k; R_0805_2012Metric
U1: Teensy4.1; Teensy41
U2: BMP280; PART_REV 1.19
U3: LIS3MDLTR; PARTREV 6
U4: LSM6DSOXTR; PARTREV 3.0

Connections:
/5V_VIN: J1.4, U1.48 (VIN)
/IMU_INT1: U4.4 (INT1)
/IMU_INT2: U4.9 (INT2)
/LED0: R3.1, U1.4 (2_OUT2)
/LED1: R4.1, U1.5 (3_LRCLK2)
/LED2: R5.1, U1.6 (4_BCLK2)
/MAG_DRDY: U3.8 (DRDY)
/MAG_INT: U3.7 (INT)
/SCL: R1.2, U1.41 (19_A5_SCL), U2.4 (SCK), U3.1 (SCL/SPC), U4.13 (SCL)
/SDA: R2.2, U1.40 (18_A4_SDA), U2.3 (SDI), U3.11 (SDA/SDI/SDO), U4.14 (SDA)
GND: C1.2, C2.2, C3.2, C4.2, C5.1, D1.1 (K), D2.1 (K), D3.1 (K), J1.3, JP1.1 (A), JP2.1 (A), JP3.1 (A), U1.1 (GND), U1.47 (GND), U2.1 (GND), U2.7 (GND__1), U3.2 (RSVD1), U3.3 (GND), U3.12 (RSVD2), U4.2 (SDX), U4.3 (SCX), U4.6 (GND), U4.7 (GND)
unnamed: D1.2 (A), R3.2
unnamed: D2.2 (A), R4.2
unnamed: D3.2 (A), R5.2
unnamed: JP1.2 (C), U2.5 (SDO)
unnamed: JP2.2 (C), U3.9 (SDO/SA1)
unnamed: JP3.2 (C), U4.1 (SDO/SA0)
unnamed: C2.1, U3.4 (C1)
VDD: C1.1, C3.1, C4.1, C5.2, JP1.3 (B), JP2.3 (B), JP3.3 (B), R1.1, R2.1, U1.46 (3V3), U2.2 (CSB), U2.6 (VDDIO), U2.8 (VDD), U3.5 (VDD), U3.6 (VDD_IO), U3.10 (CS), U4.5 (VDDIO), U4.8 (VDD), U4.12 (CS)

Notes on the sheet:
Debug LEDs
Pressure Sensor
Accelerometer+Gyro
Magnetometer
Mounting

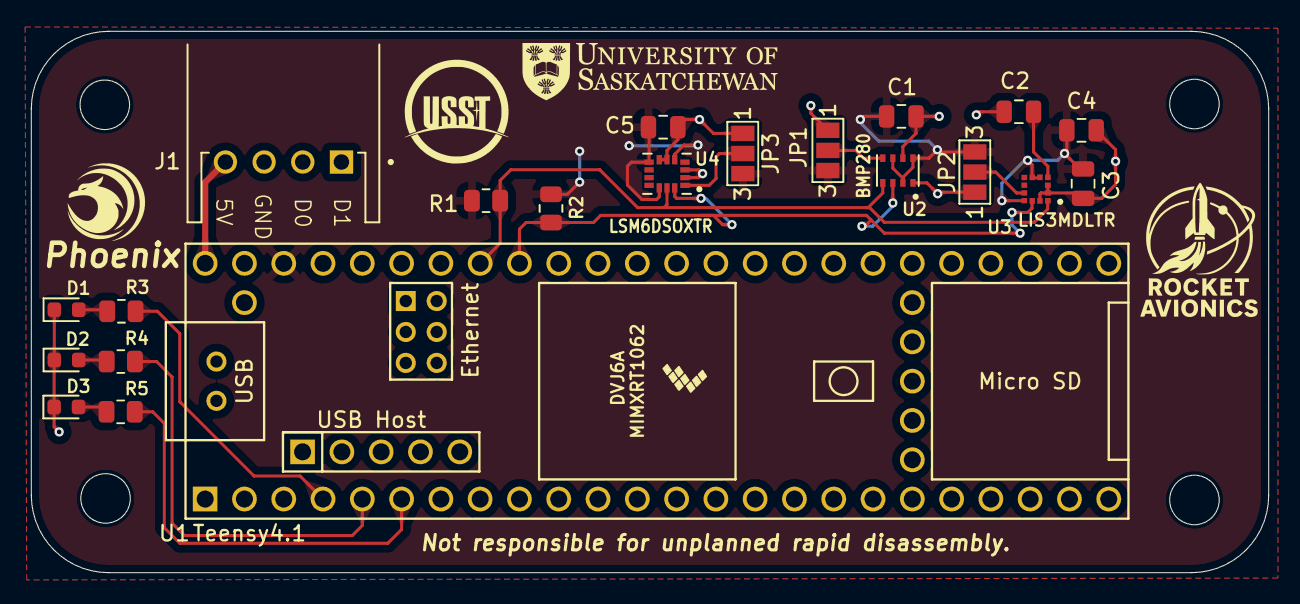
[picture p36: board phoenix.kicad_pcb from above]

Board: 2 copper layers, 80.0 x 35.0 mm, 26 parts (0 on the bottom side), 15 nets.

Other parts of the board:
P**: LOGO; phoenix_logo
