USSTRocketry/hardware/(commit log)

2024-11-25 Project setup. Created projects and custom library with sensors
    [BMP280.step, LIS3MDLTR.step, LSM6DSOXTR.step, houston.kicad_pcb, houston.kicad_sch, infozilla.kicad_pcb, infozilla.kicad_sch, phoenix.kicad_pcb]
2024-11-25 Added teensy sym and footprint to library
2024-11-25 Moved teensy files around
2024-12-05 Telemetry board design done and flight computer board started
    [B4B-XH-A.step, MCP9808T-E_MS.step, RFM95W-915S2.step, S4B-XH-A-1.step, W25Q128JVSSIQ.step, infozilla.kicad_pcb, infozilla.kicad_sch, phoenix.kicad_pcb]
2024-12-05 Udated 3d models
    [3070.STEP, 746.STEP, infozilla.kicad_pcb]
2024-12-09 Added backup radio and debug LEDs
    [infozilla.kicad_pcb, infozilla.kicad_sch, phoenix.kicad_pcb, phoenix.kicad_sch]
2025-09-03 Cutoff for LC2025
    [3362P-1-103LF.step, LM2576S-ADJ_NOPB.step, LM2576T-ADJ_LF03.step, infozilla.kicad_pcb, infozilla.step, phoenix.kicad_pcb, phoenix.step, zappy.kicad_pcb]
